yulivee/scara-bot/doc/kinematics/Kinematic.md

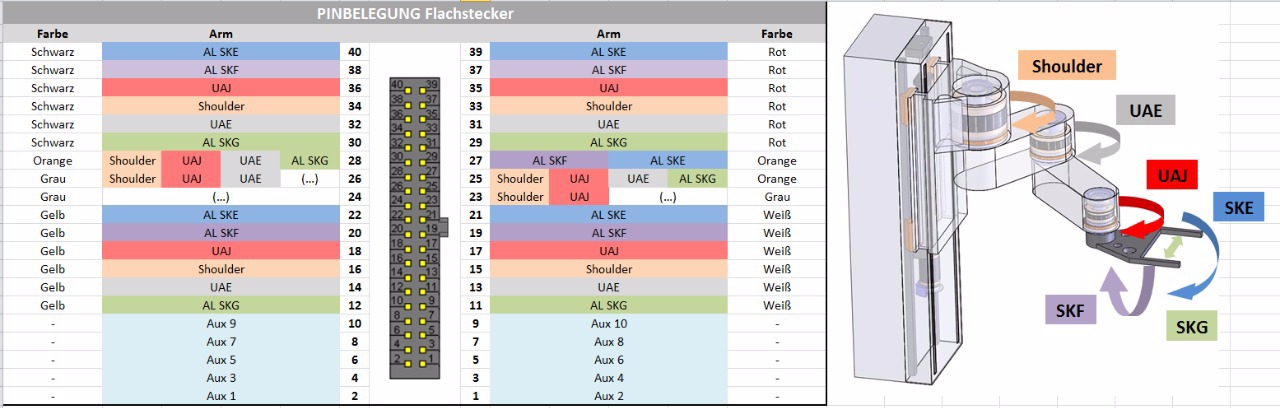
[picture p1: doc/IMG-20150512-WA0000.jpg]
robot_kinematic


# Kinematic Axis
| Axis Name | Axis Number  |
| --- |:---:|
| Z | 1  |
| SHOULDER | 2  |
| UAE | 3  |
| UAJ | 4  |
| SKE	 | 5  |
| SKF | 6  |
| SKG | 7  |
