yulivee/scara-bot/doc/gear_ratios/GearRatio.md

# Gear Ratio of Motor gears

### Gear 1
| Diameter | Teeth |
| :---: | :---: |
| 5.5 cm | 11 |

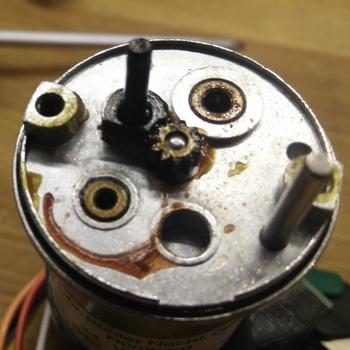
[picture p2: doc/gear_1_lowres.jpg]
Gear 1


### Gear 2
| Diameter | Teeth |
| :---: | :---: |
| 13.5 cm  | 32 |
|  5.6 cm  | 11 |

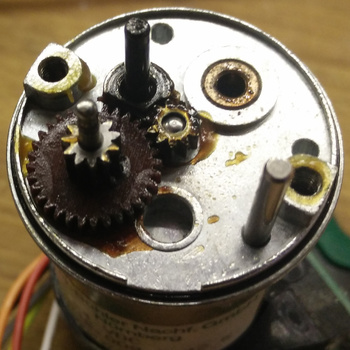
[picture p3: doc/gear_2_lowres.jpg]
Gear 2


### Gear 3
| Diameter | Teeth |
| :---: | :---: |
| 14.5 cm  | 34 |
|  7.5 cm  | 12 |

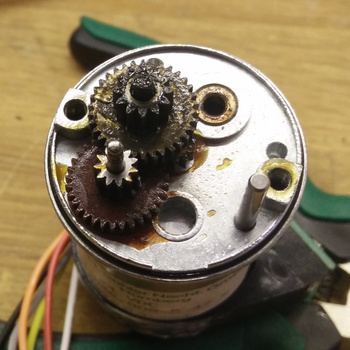
[picture p4: doc/gear_3_lowres.jpg]
Gear 3


### Gear 4
| Diameter | Teeth |
| :---: | :---: |
| 14.4 cm  | 27 |

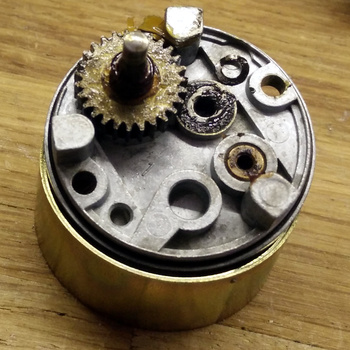
[picture p5: doc/gear_4_lowres.jpg]
Gear 4


## Gear Ratio

32/11 x 34/11 x 27/12 = 20 28/121 ~ 20.23140496
