yulivee/scara-bot/doc/kinematics/Kinematic.pdf

# COBRA industrial robot Kinematic

### Sandra Schuhmacher & Daniel Veeckman

### 19. Januar 2019

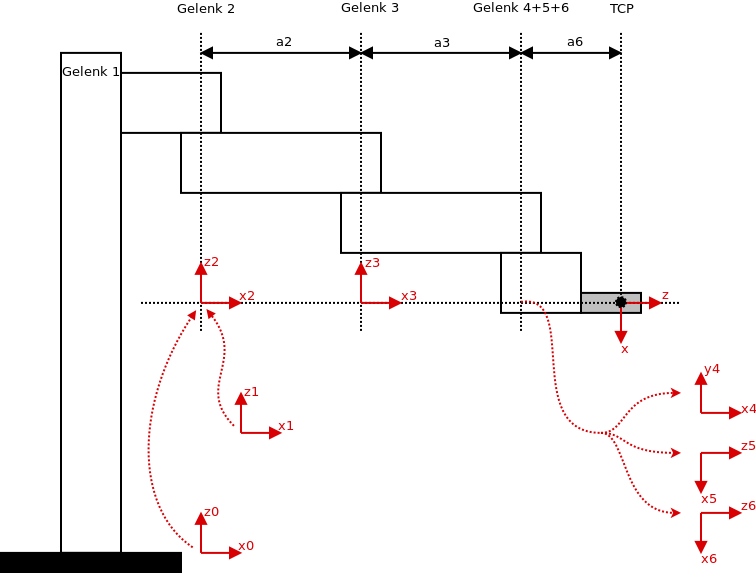
[picture p6: figure]

## 1 Gelenke

d1 = d1 | q1 = 0◦
d2 = 0 | q2 = θ2
d3 = 0 | q3 = θ3
d4 = 0 | q4 = θ4
d5 = 0 | q5 = θ5
d6 = 0 | q6 = θ6

## 2 Armteile

a1 = 0 | α1 = 0◦
a2 = 255mm | α2 = 0◦
a3 = 255mm | α3 = 0◦
a4 = 0 | α4 = 90◦
a5 = 0 | α5 = 90◦
a6 = 175mm | α6 = 0◦

1

## 3 Denavit-Hardenberg Matrix

0A1 =

1 0 0 0
0 1 0 0
0 0 1 d1
0 0 0 0

1A2 =

cosθ2 | −sinθ2 | 0 a2 cosθ2
sinθ2 | cosθ2 | 0 a2 cosθ2
0 | 0 | 1 | 0
0 | 0 | 0 | 1

2A3 =

cosθ3 | −sinθ3 | 0 a3 cosθ3
sinθ3 | cosθ3 | 0 a3 cosθ3
0 | 0 | 1 | 0
0 | 0 | 0 | 1

3A4 =

cosθ4 | 0 | sinθ4 | 0
sinθ4 | 0 −cosθ4 | 0
0 | 1 | 0 | 0
0 | 0 | 0 | 1

4A5 =

cosθ5 | 0 | sinθ5 | 0
sinθ5 | 0 −cosθ5 | 0
0 | 1 | 0 | 0
0 | 0 | 0 | 1

5A6 =

cosθ6 | −sinθ6 | 0 a6 cosθ6
sinθ6 | cosθ6 | 0 a6 cosθ6
0 | 0 | 1 | 0
0 | 0 | 0 | 1

2
