yulivee/scara-bot/doc/kinematics/Kinematic.tex

% --------------------------------------------------------------
% This is all preamble stuff that you don't have to worry about.
% Head down to where it says "Start here"
% --------------------------------------------------------------
 
\documentclass[12pt]{article}
\usepackage[utf8]{inputenc} 
\usepackage[ngerman]{babel} 
\usepackage[T1]{fontenc} 
\usepackage[a4paper,left=20mm,right=20mm,top=10mm,bottom=10mm,headheight=12pt, headsep=0pt, nohead, nofoot]{geometry}
\usepackage{amsmath,amsthm,amssymb}
\usepackage{graphicx}
 
\newcommand{\N}{\mathbb{N}}
\newcommand{\Z}{\mathbb{Z}}
 
\newenvironment{theorem}[2][Theorem]{\begin{trivlist}
\item[\hskip \labelsep {\bfseries #1}\hskip \labelsep {\bfseries #2.}]}{\end{trivlist}}
\newenvironment{lemma}[2][Lemma]{\begin{trivlist}
\item[\hskip \labelsep {\bfseries #1}\hskip \labelsep {\bfseries #2.}]}{\end{trivlist}}
\newenvironment{exercise}[2][Exercise]{\begin{trivlist}
\item[\hskip \labelsep {\bfseries #1}\hskip \labelsep {\bfseries #2.}]}{\end{trivlist}}
\newenvironment{reflection}[2][Reflection]{\begin{trivlist}
\item[\hskip \labelsep {\bfseries #1}\hskip \labelsep {\bfseries #2.}]}{\end{trivlist}}
\newenvironment{proposition}[2][Proposition]{\begin{trivlist}
\item[\hskip \labelsep {\bfseries #1}\hskip \labelsep {\bfseries #2.}]}{\end{trivlist}}
\newenvironment{corollary}[2][Corollary]{\begin{trivlist}
\item[\hskip \labelsep {\bfseries #1}\hskip \labelsep {\bfseries #2.}]}{\end{trivlist}}
 
\begin{document}
 
% --------------------------------------------------------------
%                         Start here
% --------------------------------------------------------------
 
\title{COBRA industrial robot Kinematic}%replace X with the appropriate number
\author{Sandra Schuhmacher \& Daniel Veeckman} %if necessary, replace with your course title
 
\maketitle


 
\section{Gelenke}

\begin{align*}
    d_1 &= d_1 & q_1 &= 0^\circ \\
    d_2 &= 0   & q_2 &= \theta_2 \\
    d_3 &= 0   & q_3 &= \theta_3 \\
    d_4 &= 0   & q_4 &= \theta_4 \\
    d_5 &= 0   & q_5 &= \theta_5 \\
    d_6 &= 0   & q_6 &= \theta_6 \\
\end{align*}
 
\section{Armteile}

\begin{align*}
    a_1 &= 0     & \alpha_1 &= 0^\circ \\
    a_2 &= 255mm & \alpha_2 &= 0^\circ \\
    a_3 &= 255mm & \alpha_3 &= 0^\circ \\
    a_4 &= 0     & \alpha_4 &= 90^\circ \\
    a_5 &= 0     & \alpha_5 &= 90^\circ \\
    a_6 &= 175mm & \alpha_6 &= 0^\circ \\
\end{align*}
 
\section{Denavit-Hardenberg Matrix}
\begin{align*}
{}^0 A_1 &=
\begin{pmatrix}
    1 & 0 & 0 & 0 \\
    0 & 1 & 0 & 0 \\
    0 & 0 & 1 & d_1 \\
    0 & 0 & 0 & 0 \\
\end{pmatrix} \\
\\
{}^1 A_2 &=
\begin{pmatrix}
    cos\theta_2 & -sin\theta_2 & 0 & a_2~cos\theta_2 \\
    sin\theta_2 & cos\theta_2 & 0 & a_2~cos\theta_2 \\
    0 & 0 & 1 & 0 \\
    0 & 0 & 0 & 1 \\
\end{pmatrix} \\
\\
{}^2 A_3 &=
\begin{pmatrix}
    cos\theta_3 & -sin\theta_3 & 0 & a_3~cos\theta_3 \\
    sin\theta_3 & cos\theta_3 & 0 & a_3~cos\theta_3 \\
    0 & 0 & 1 & 0 \\
    0 & 0 & 0 & 1 \\
\end{pmatrix} \\
\\
{}^3 A_4 &=
\begin{pmatrix}
    cos\theta_4 & 0 & sin\theta_4 & 0 \\
    sin\theta_4 & 0 & -cos\theta_4 & 0 \\
    0 & 1 & 0 & 0 \\
    0 & 0 & 0 & 1 \\
\end{pmatrix} \\
\\
{}^4 A_5 &=
\begin{pmatrix}
    cos\theta_5 & 0 & sin\theta_5 & 0 \\
    sin\theta_5 & 0 & -cos\theta_5 & 0 \\
    0 & 1 & 0 & 0 \\
    0 & 0 & 0 & 1 \\
\end{pmatrix} \\
\\
{}^5 A_6 &=
\begin{pmatrix}
    cos\theta_6 & -sin\theta_6 & 0 & a_6~cos\theta_6 \\
    sin\theta_6 & cos\theta_6 & 0 & a_6~cos\theta_6 \\
    0 & 0 & 1 & 0 \\
    0 & 0 & 0 & 1 \\
\end{pmatrix} \\
\end{align*}

\end{document}
