yulivee/scara-bot/doc/optical_counter_switches/OPB971_optical_switch_diagram.JPG

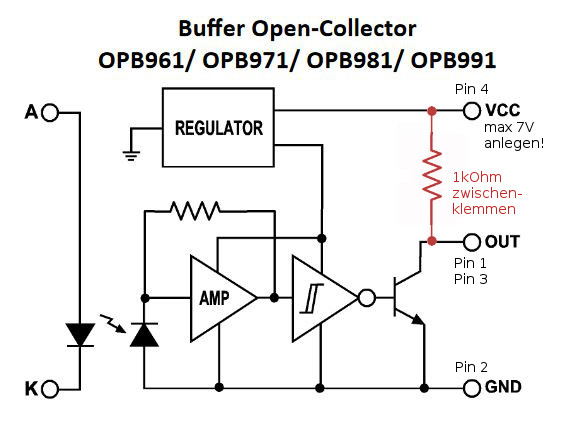
doc/optical_counter_switches/OPB971_optical_switch_diagram.JPG
