yulivee/scara-bot/doc/Pinout_Comm_Board.png

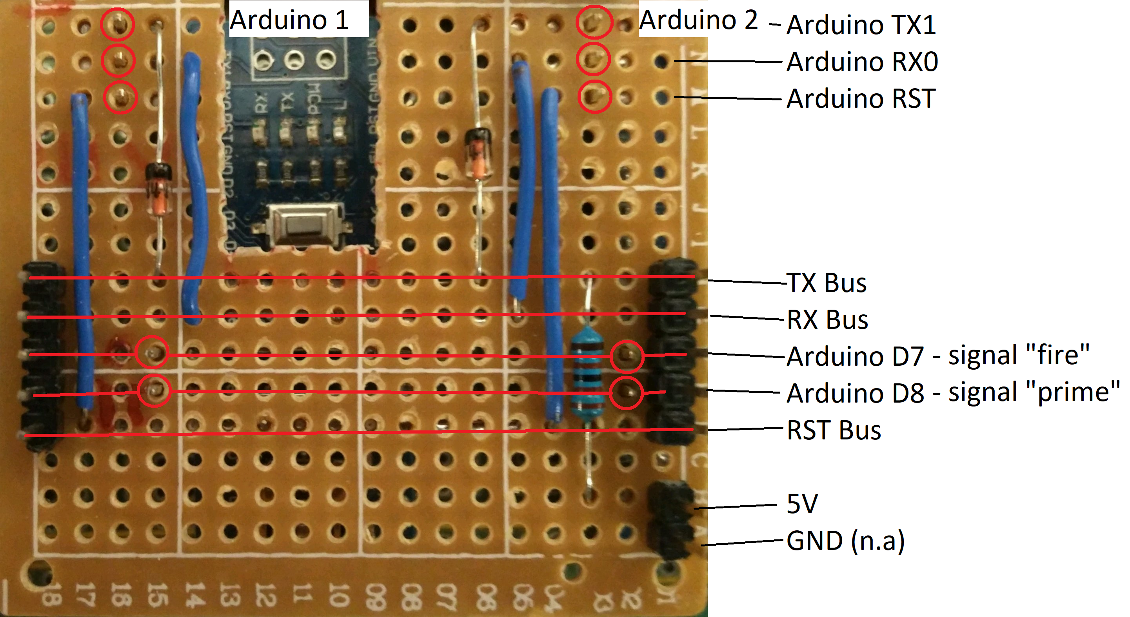
doc/Pinout_Comm_Board.png
