yulivee/scara-bot/(list of files, drawings)

Other design files:
doc/layouts/Layout_master_board.fzz
doc/layouts/Layout_safety_board.fzz
doc/layouts/Layout_slave_board.fzz
doc/layouts/Layout_slave_board_V2_comm.fzz
doc/optical_counter_switches/SKE_Originalverkabelung.fzz
