yulivee/scara-bot/doc/optical_counter_switches/Original_Wiring.jpg

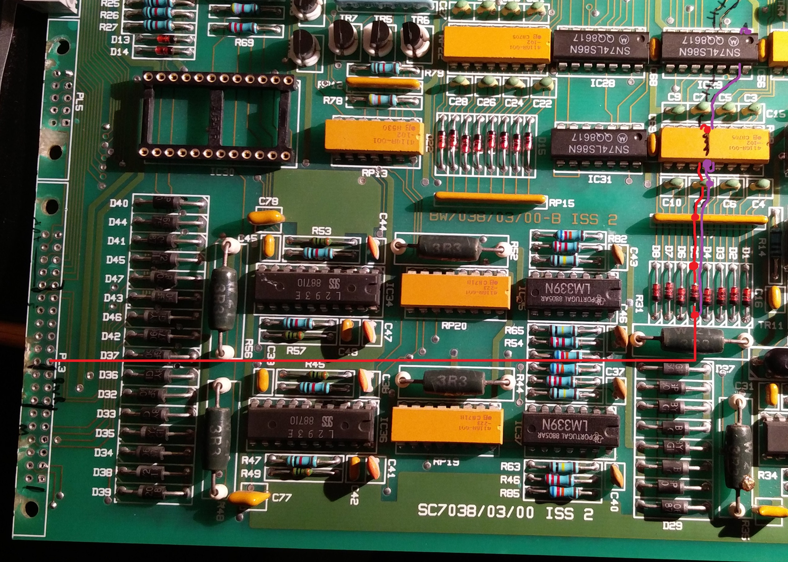
doc/optical_counter_switches/Original_Wiring.jpg
