yulivee/scara-bot/doc/optical_counter_switches/Original_Wiring_Layout.jpg

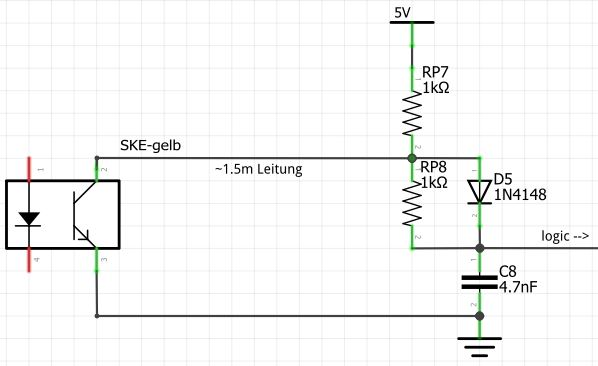
doc/optical_counter_switches/Original_Wiring_Layout.jpg
