yulivee/scara-bot/doc/optical_counter_switches/Original_Wiring_Motors.png

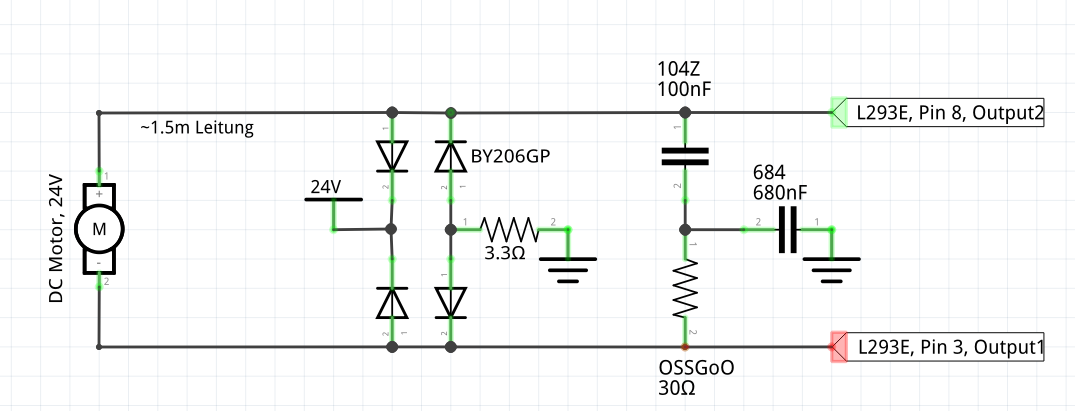
doc/optical_counter_switches/Original_Wiring_Motors.png
