yulivee/scara-bot/doc/sample_code/master.sample.cpp

/*
  Multiple Serial test

  Receives from the main serial port, sends to the others.
  Receives from serial port 1, sends to the main serial (Serial 0).

  This example works only with boards with more than one serial like Arduino Mega, Due, Zero etc.

  The circuit:
  - any serial device attached to Serial port 1
  - Serial Monitor open on Serial port 0

  created 30 Dec 2008
  modified 20 May 2012
  by Tom Igoe & Jed Roach
  modified 27 Nov 2015
  by Arturo Guadalupi

  This example code is in the public domain.
*/
void serial_write_int(int val){
  Serial1.write(lowByte(val));
  Serial1.write(highByte(val));
}

void setup() {
  // initialize both serial ports:
  Serial.begin(9600);
  Serial1.begin(9600);
}

void loop() {
  // read from port 1(Slave), send to port 0(PC):
  if (Serial1.available()) {
    int inByte = Serial1.read();
    Serial.write(inByte);
  }

  // read from port 0 (PC), send to port 1(Slave):
  if (Serial.available()) {
    int inByte = Serial.read();
    serial_write_int(-300);
    //Serial1.write(inByte);
  }
}
