yulivee/scara-bot/(commit log)

2017-01-27 Initial Commit for Arduino Mega 2560
2017-02-10 added sample snippet for encoder control
2017-03-09 experimenting with encoder readings
2017-04-29 Testing Interrupts
2017-05-01 forgot to add pid.c
2017-05-04 pid kinda works. with analog write, there is the counting issue again
    [main.cpp]
2017-05-06 Debugging session 1: Burning PID
    [main.cpp]
2017-05-06 PID works
2017-05-06 working PID, hell yeah
2017-05-06 pid works. interrupt on rising AND falling interrupts for better resolution next time
2017-05-08 interrupting on CHANGE instead of RISING for better resolution
2018-03-11 Corrected Interrupt-Call
2018-03-24 added fritzing
    [board1.fzz]
2018-03-25 Corrected Logic in home and toggle_motor
    [main.cpp]
2018-03-25 Fritzing for Mother and Sisterboard finished
    [board1.fzz]
2018-03-27 added arduino pinout png
2018-04-03 added documentation of the motor gears
2018-04-03 added gear ratio to documentation
2018-04-03 first draft of params.yaml with gear ratios
2018-09-02 Erstumsetzung Slave
    Getestete Erstumsetzung der 1 zu 1 kommunikation
2018-09-13 Mach das es mit UBUNTU geht, offboard LED eingebunden
2018-10-14 bugfix
    changed word to int
    [main.cpp]
2018-10-17 Implemented ping function
    Function echoes message back to master. Set the groundwork for more functions. Testing is still needed!
2018-10-20 Create kinematic.md
    Added axis enumeration for robot motors
2019-01-18 added schema of kinematics
2019-01-18 Updated Kinematic Equations
2019-03-15 Resorting of doc folder
    Complete resorting of doc folder, compacting of data in the .md files, description comments added to all program files
    [Layout_slave_board.fzz]
2019-03-15 Documentation for SPI Communication
    SPI Diagram and Fritzing layout created
    [Layout_slave_board_V2_comm.fzz]
2019-03-16 Reworking Communication
    Com Diagramms and Markups created and updated. Strted to implement changes to Code. Fire Pin has bee removed completely
2019-03-17 Updated Master Slave Communication
    removed fire pin, renamed prime pin to slave select pin (ss_pin), implemented all current functions. Testing pending, waiting on hardware
2019-03-21 new fuction and pid test
    [Layout_slave_board_V2_comm.fzz]
2019-03-29 Comm test with 4 Slaves
    [Layout_slave_board_V2_comm.fzz]
2019-04-05 Created an upper bound for the delta part of PID to avoid variable overflow
2019-04-05 added calculation sheet of pid values
    [pid-calculations.ods]
2019-04-06 Fixed and tested PID
    position of bounds function and chages long to int
    [main.cpp]
2019-04-12 communication expanded to always expect responce from slaves
    error handling still needs to be implemented but can not be done manually.
    [main.cpp]
2019-04-14 Layout for Z Joint Board
    [Layout_slave_board_V2_comm.fzz]
2019-04-19 speed, zone and error_handling
    Implemented speed and zone controls, tidied up code ans commends, reworked error handling. First test with Z board
    [Layout_slave_board_V2_comm.fzz]
2019-04-24 Master Board Layout angepasst in Doku
    [Layout_master_board.fzz, Layout_slave_board_V2_comm.fzz]
2019-05-03 Documented Original Wiring of Encoder Inputs
    [Layout_slave_board_V2_comm.fzz, SKE_Originalverkabelung.fzz]
2019-05-04 Added Layout for Safety Board
    [Layout_safety_board.fzz, Layout_slave_board_V2_comm.fzz]
2019-05-06 Implemented Python GUI
    Single Joint Control
2019-05-10 added speed limiter to pid controller
2019-05-26 Original Motor Wiring and Reset Wiring Layout added
    [Layout_master_board.fzz, Layout_slave_board_V2_comm.fzz, SKE_Originalverkabelung.fzz]
